0y8w1x/daemon_carrier_board/README.md

# daemon_carrier_board
an improved revision is available here: https://github.com/0y8w1x/daemon_baseboard
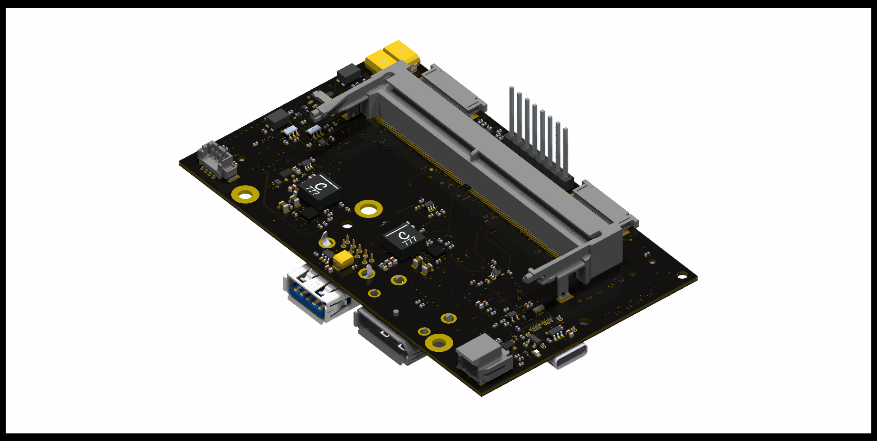
[picture p1: daemon_carrier_board_front.png]
board_render_front

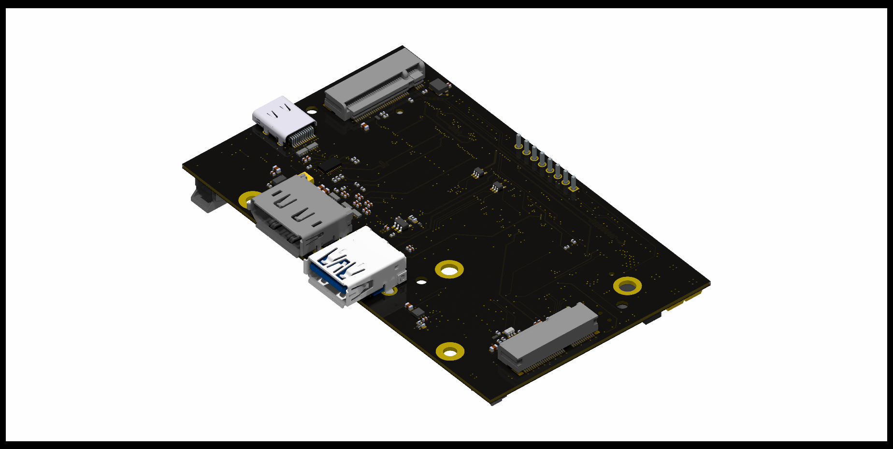
[picture p2: daemon_carrier_board_back.png]
board_render_back
