0y8w1x/daemon_carrier_board/csi.kicad_sch

## KiCad design csi.kicad_sch (2024-04-20)

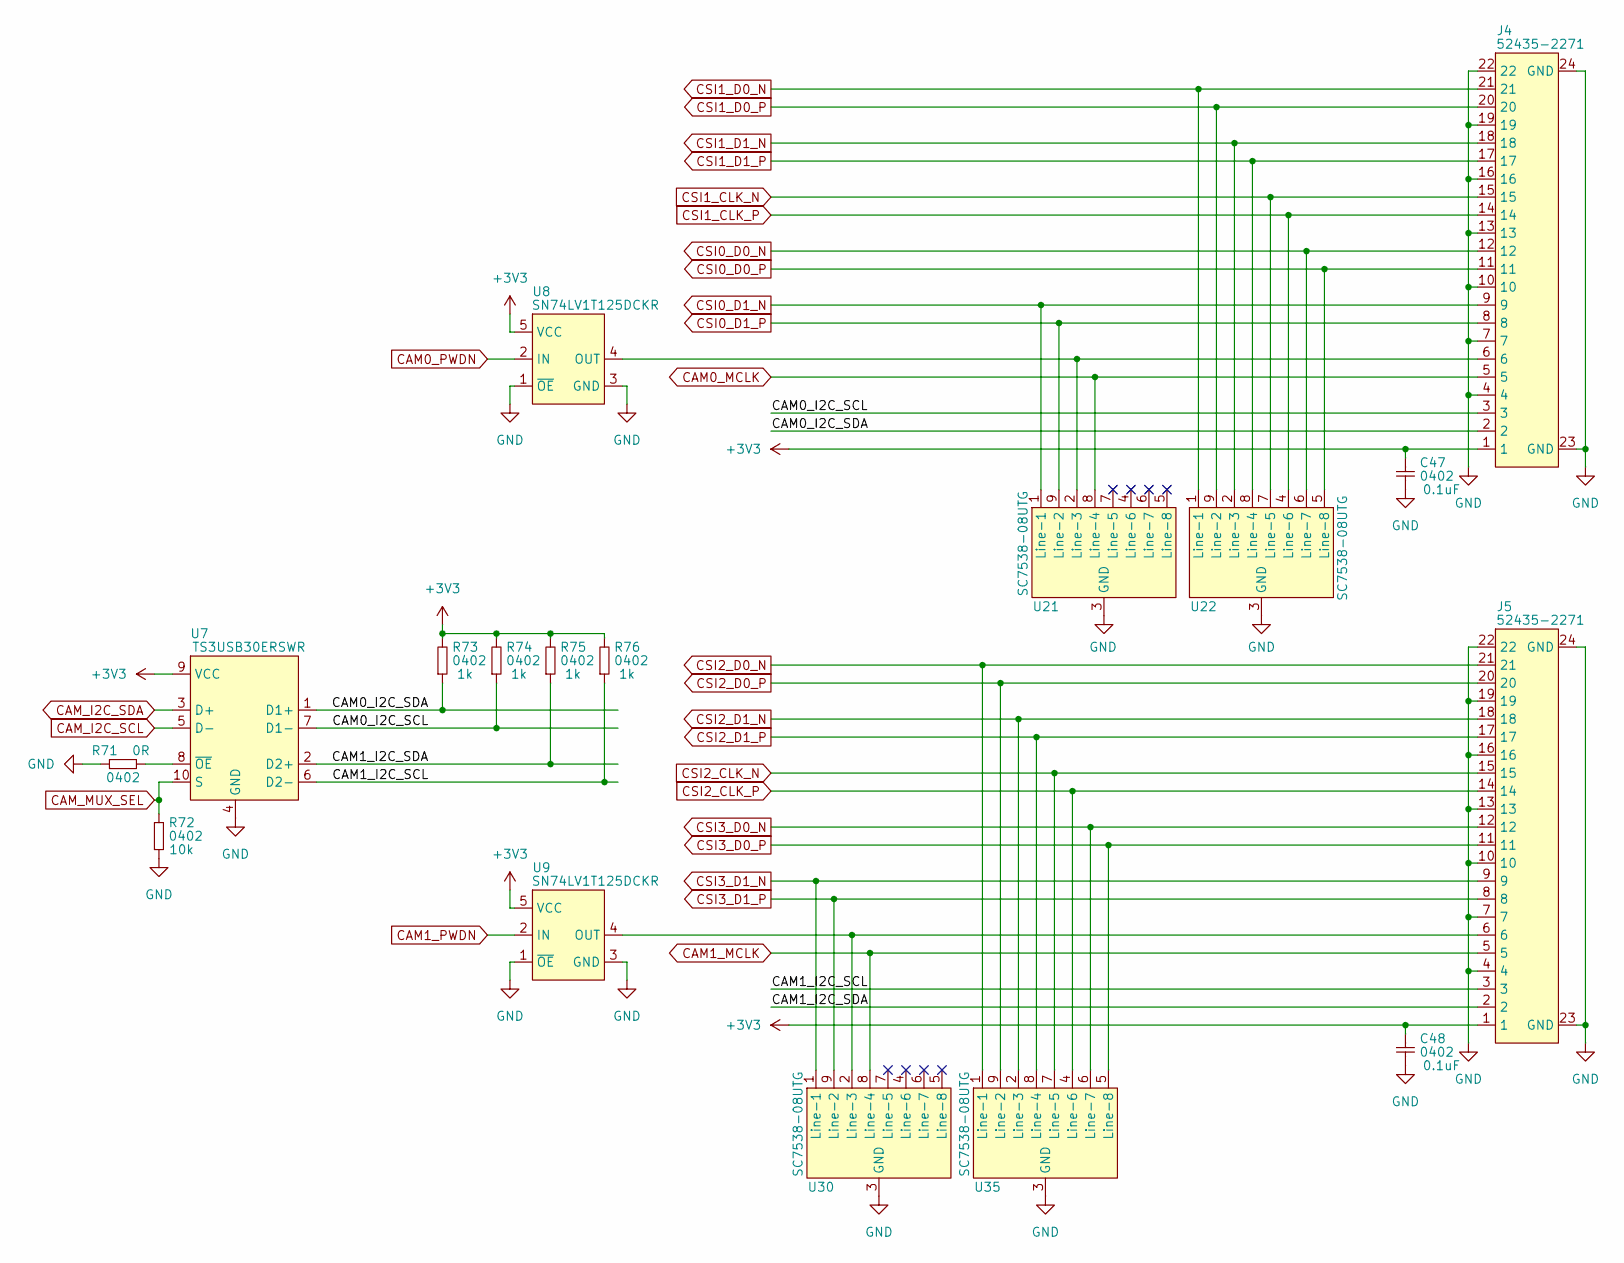
[picture p10: schematic csi.kicad_sch]

Parts:
C47, C48: 0.1uF; 0402_cap
J4, J5: 52435-2271
R71: 0R; 0402_res
R72: 10k; 0402_res
R73, R74, R75, R76: 1k; 0402_res
U7: TS3USB30E
U8, U9: SN74LV1T125
U21, U22, U30, U35: SC7538

Connections:
+3V3: C47.2, C48.2, J4.1, J5.1, R73.2, R74.2, R75.2, R76.2, U7.9 (VCC), U8.5 (VCC), U9.5 (VCC)
CAM0_I2C_SCL: J4.3, R74.1, U7.7 (D1-)
CAM0_I2C_SDA: J4.2, R73.1, U7.1 (D1+)
CAM0_MCLK: J4.5, U21.8 (Line-4)
CAM0_PWDN: U8.2 (IN)
CAM1_I2C_SCL: J5.3, R76.1, U7.6 (D2-)
CAM1_I2C_SDA: J5.2, R75.1, U7.2 (D2+)
CAM1_MCLK: J5.5, U30.8 (Line-4)
CAM1_PWDN: U9.2 (IN)
CAM_I2C_SCL: U7.5 (D-)
CAM_I2C_SDA: U7.3 (D+)
CAM_MUX_SEL: R72.2, U7.10 (S)
CSI0_D0_N: J4.12, U22.6 (Line-7)
CSI0_D0_P: J4.11, U22.5 (Line-8)
CSI0_D1_N: J4.9, U21.1 (Line-1)
CSI0_D1_P: J4.8, U21.9 (Line-2)
CSI1_CLK_N: J4.15, U22.7 (Line-5)
CSI1_CLK_P: J4.14, U22.4 (Line-6)
CSI1_D0_N: J4.21, U22.1 (Line-1)
CSI1_D0_P: J4.20, U22.9 (Line-2)
CSI1_D1_N: J4.18, U22.2 (Line-3)
CSI1_D1_P: J4.17, U22.8 (Line-4)
CSI2_CLK_N: J5.15, U35.7 (Line-5)
CSI2_CLK_P: J5.14, U35.4 (Line-6)
CSI2_D0_N: J5.21, U35.1 (Line-1)
CSI2_D0_P: J5.20, U35.9 (Line-2)
CSI2_D1_N: J5.18, U35.2 (Line-3)
CSI2_D1_P: J5.17, U35.8 (Line-4)
CSI3_D0_N: J5.12, U35.6 (Line-7)
CSI3_D0_P: J5.11, U35.5 (Line-8)
CSI3_D1_N: J5.9, U30.1 (Line-1)
CSI3_D1_P: J5.8, U30.9 (Line-2)
GND: C47.1, C48.1, J4.4, J4.7, J4.10, J4.13, J4.16, J4.19, J4.22, J4.23 (GND), J4.24 (GND), J5.4, J5.7, J5.10, J5.13, J5.16, J5.19, J5.22, J5.23 (GND), J5.24 (GND), R71.1, R72.1, U7.4 (GND), U8.1 (~OE), U8.3 (GND), U9.1 (~OE), U9.3 (GND), U21.3 (GND), U22.3 (GND), U30.3 (GND), U35.3 (GND)
unnamed: J4.6, U8.4 (OUT), U21.2 (Line-3)
unnamed: J5.6, U9.4 (OUT), U30.2 (Line-3)
unnamed: R71.2, U7.8 (~OE)
