0y8w1x/daemon_carrier_board/display_port.kicad_sch

## KiCad design display_port.kicad_sch (2024-04-20)

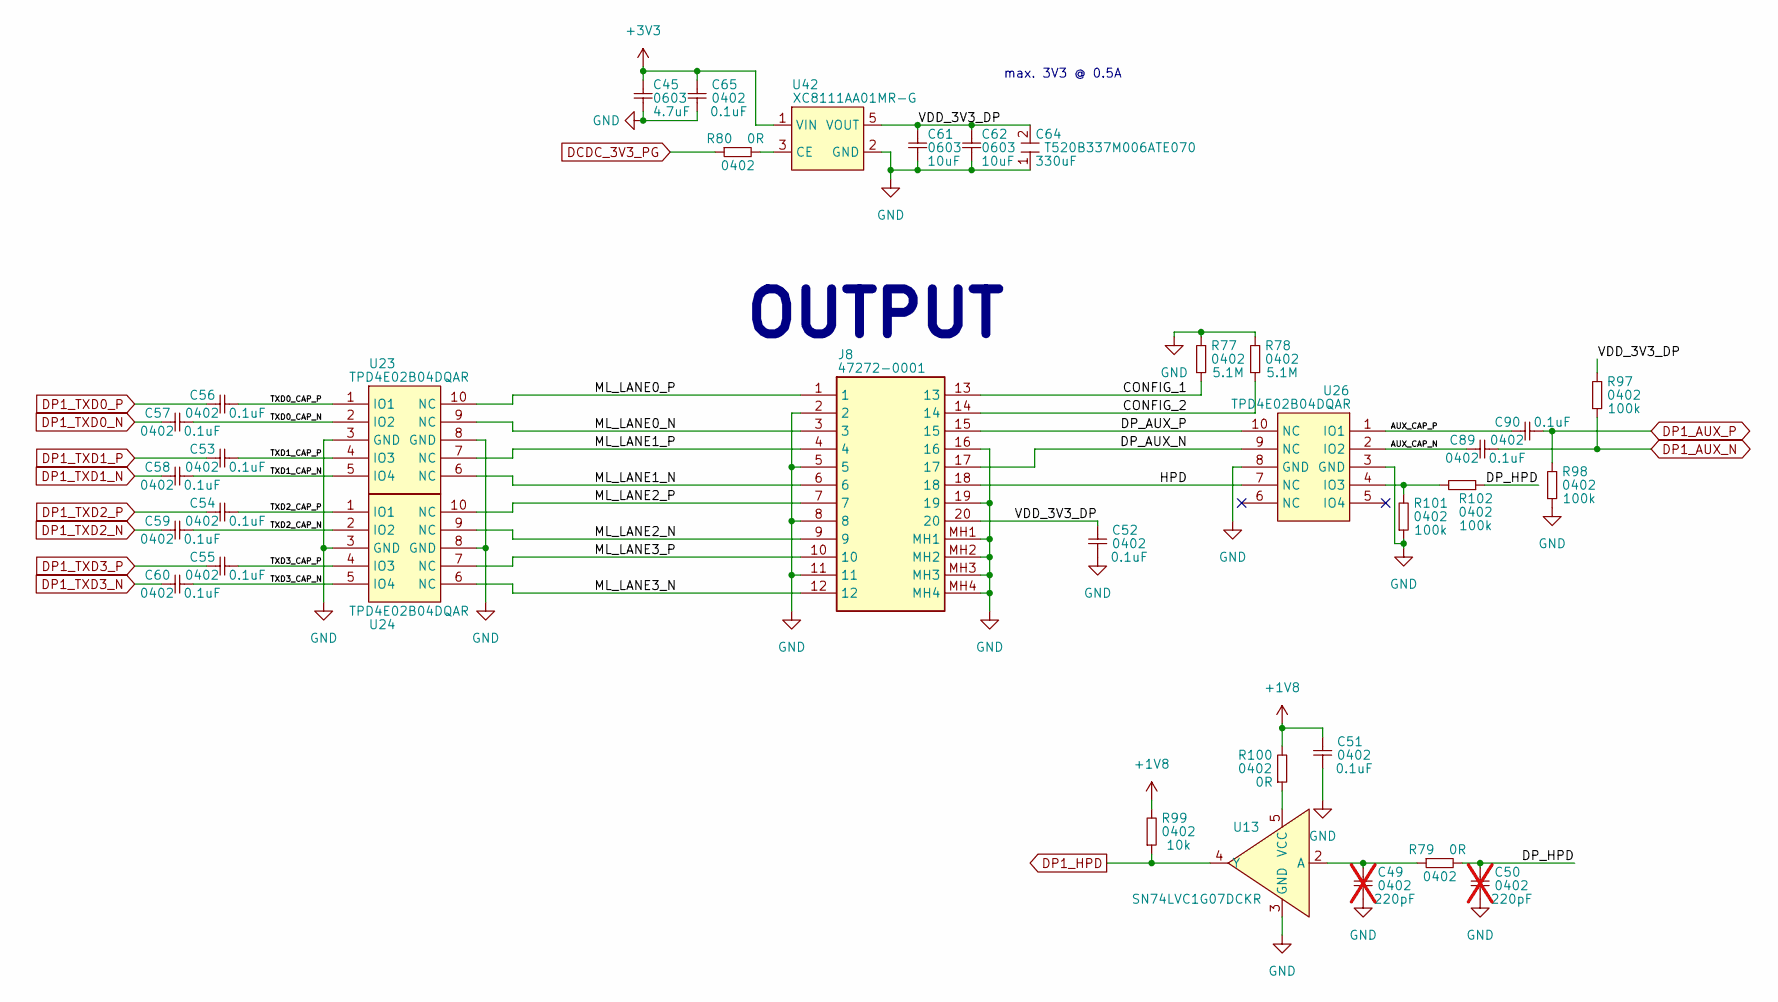
[picture p11: schematic display_port.kicad_sch]

Parts:
C45: 4.7uF; 0603_cap
C49, C50: 220pF; 0402_cap; not fitted
C51, C52, C53, C54, C55, C56, C57, C58, C59, C60, C65, C89, C90: 0.1uF; 0402_cap
C61, C62: 10uF; 0603_cap
C64: 330uF; T520B337M006ATE070
J8: 472720001; Mouser Part Number 538-47272-0001
R77, R78: 5.1M; 0402_res
R79, R80, R100: 0R; 0402_res
R97, R98, R101, R102: 100k; 0402_res
R99: 10k; 0402_res
U13: SN74LVC1G07
U23, U24, U26: TPD4E02B04DQAR
U42: XC8111

Connections:
+1V8: C51.2, R99.2, R100.2
+3V3: C45.2, C65.2, U42.1 (VIN)
AUX_CAP_N: C89.2, U26.2 (IO2)
AUX_CAP_P: C90.2, U26.1 (IO1)
CONFIG_1: J8.13, R77.1
CONFIG_2: J8.14, R78.1
DCDC_3V3_PG: R80.1
DP1_AUX_N: C89.1, R97.1
DP1_AUX_P: C90.1, R98.2
DP1_HPD: R99.1, U13.4 (Y)
DP1_TXD0_N: C57.2
DP1_TXD0_P: C56.2
DP1_TXD1_N: C58.2
DP1_TXD1_P: C53.2
DP1_TXD2_N: C59.2
DP1_TXD2_P: C54.2
DP1_TXD3_N: C60.2
DP1_TXD3_P: C55.2
DP_AUX_N: J8.17, U26.9 (NC)
DP_AUX_P: J8.15, U26.10 (NC)
DP_HPD: C50.2, R79.2, R102.1
GND: C45.1, C49.1, C50.1, C51.1, C52.1, C61.1, C62.1, C64.1, C65.1, J8.2, J8.5, J8.8, J8.11, J8.16, J8.19, J8.MH1, J8.MH2, J8.MH3, J8.MH4, R77.2, R78.2, R98.1, R101.1, U13.3 (GND), U23.3 (GND), U23.8 (GND), U24.3 (GND), U24.8 (GND), U26.3 (GND), U26.8 (GND), U42.2 (GND)
HPD: J8.18, U26.7 (NC)
ML_LANE0_N: J8.3, U23.9 (NC)
ML_LANE0_P: J8.1, U23.10 (NC)
ML_LANE1_N: J8.6, U23.6 (NC)
ML_LANE1_P: J8.4, U23.7 (NC)
ML_LANE2_N: J8.9, U24.9 (NC)
ML_LANE2_P: J8.7, U24.10 (NC)
ML_LANE3_N: J8.12, U24.6 (NC)
ML_LANE3_P: J8.10, U24.7 (NC)
unnamed: C49.2, R79.1, U13.2 (A)
unnamed: R80.2, U42.3 (CE)
unnamed: R100.1, U13.5 (VCC)
unnamed: R101.2, R102.2, U26.4 (IO3)
TXD0_CAP_N: C57.1, U23.2 (IO2)
TXD0_CAP_P: C56.1, U23.1 (IO1)
TXD1_CAP_N: C58.1, U23.5 (IO4)
TXD1_CAP_P: C53.1, U23.4 (IO3)
TXD2_CAP_N: C59.1, U24.2 (IO2)
TXD2_CAP_P: C54.1, U24.1 (IO1)
TXD3_CAP_N: C60.1, U24.5 (IO4)
TXD3_CAP_P: C55.1, U24.4 (IO3)
VDD_3V3_DP: C52.2, C61.2, C62.2, C64.2, J8.20, R97.2, U42.5 (VOUT)

Notes on the sheet:
max. 3V3 @ 0.5A
OUTPUT
