0y8w1x/daemon_carrier_board/gpio_fan_debug.kicad_sch

## KiCad design gpio_fan_debug.kicad_sch (2024-04-20)

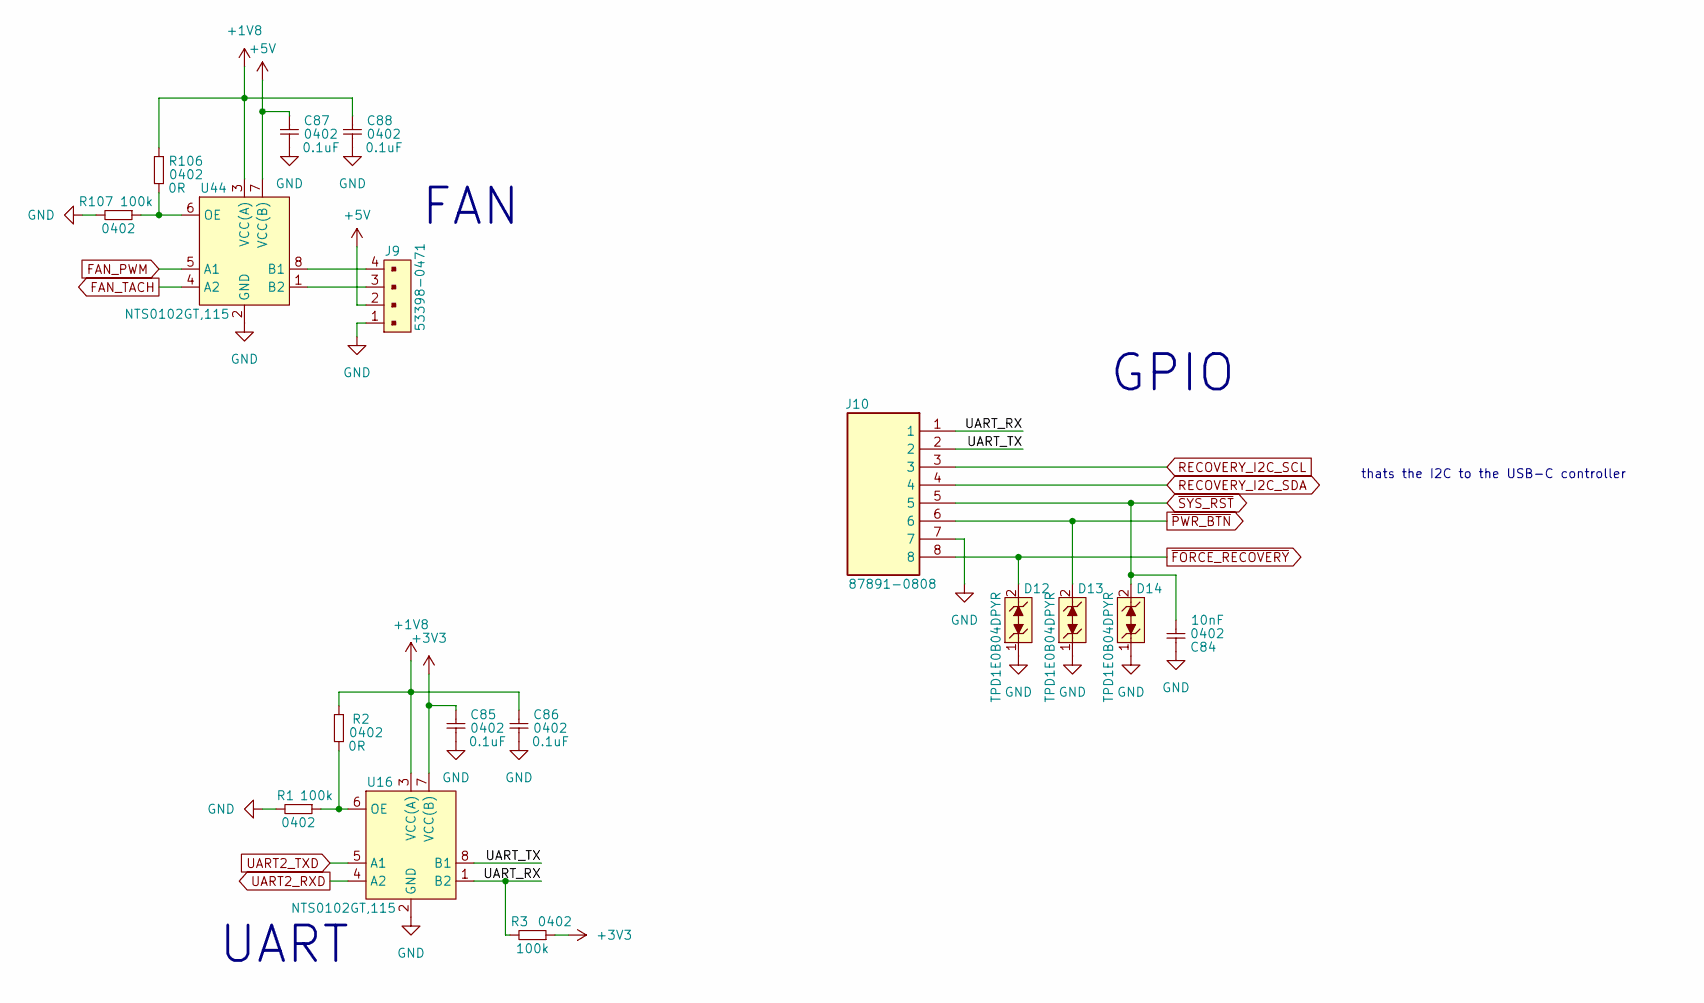
[picture p12: schematic gpio_fan_debug.kicad_sch]

Parts:
C84: 10nF; 0402_cap
C85, C86, C87, C88: 0.1uF; 0402_cap
D12, D13, D14: XDFN-2_1x0.60mm; MPN TPD1E0B04DPYR
J9: Molex_PicoBlade_53398-0471_1x04-1MP_P1.25mm_Vertical; MPN 0533980471
J10: HDRV8W69P0X254_1X8_2032X251X1641P; Mouser Part Number 538-87891-0808
R1, R3, R107: 100k; 0402_res
R2, R106: 0R; 0402_res
U16, U44: NTS0102

Connections:
+1V8: C86.2, C88.2, R2.2, R106.2, U16.3 (VCC(A)), U44.3 (VCC(A))
+3V3: C85.2, R3.1, U16.7 (VCC(B))
+5V: C87.2, J9.2, U44.7 (VCC(B))
FAN_PWM: U44.5 (A1)
FAN_TACH: U44.4 (A2)
GND: C84.2, C85.1, C86.1, C87.1, C88.1, D12.1, D13.1, D14.1, J9.1, J10.7, R1.2, R107.2, U16.2 (GND), U44.2 (GND)
unnamed: J9.3, U44.1 (B2)
unnamed: J9.4, U44.8 (B1)
unnamed: R1.1, R2.1, U16.6 (OE)
unnamed: R106.1, R107.1, U44.6 (OE)
RECOVERY_I2C_SCL: J10.3
RECOVERY_I2C_SDA: J10.4
UART2_RXD: U16.4 (A2)
UART2_TXD: U16.5 (A1)
UART_RX: J10.1, R3.2, U16.1 (B2)
UART_TX: J10.2, U16.8 (B1)
~FORCE_RECOVERY: D12.2, J10.8
~PWR_BTN: D13.2, J10.6
~SYS_RST: C84.1, D14.2, J10.5

Notes on the sheet:
UART
thats the I2C to the USB-C controller
FAN
GPIO
