0y8w1x/daemon_carrier_board/ldo_3V3_5V.kicad_sch

## KiCad design ldo_3V3_5V.kicad_sch (2024-04-20)

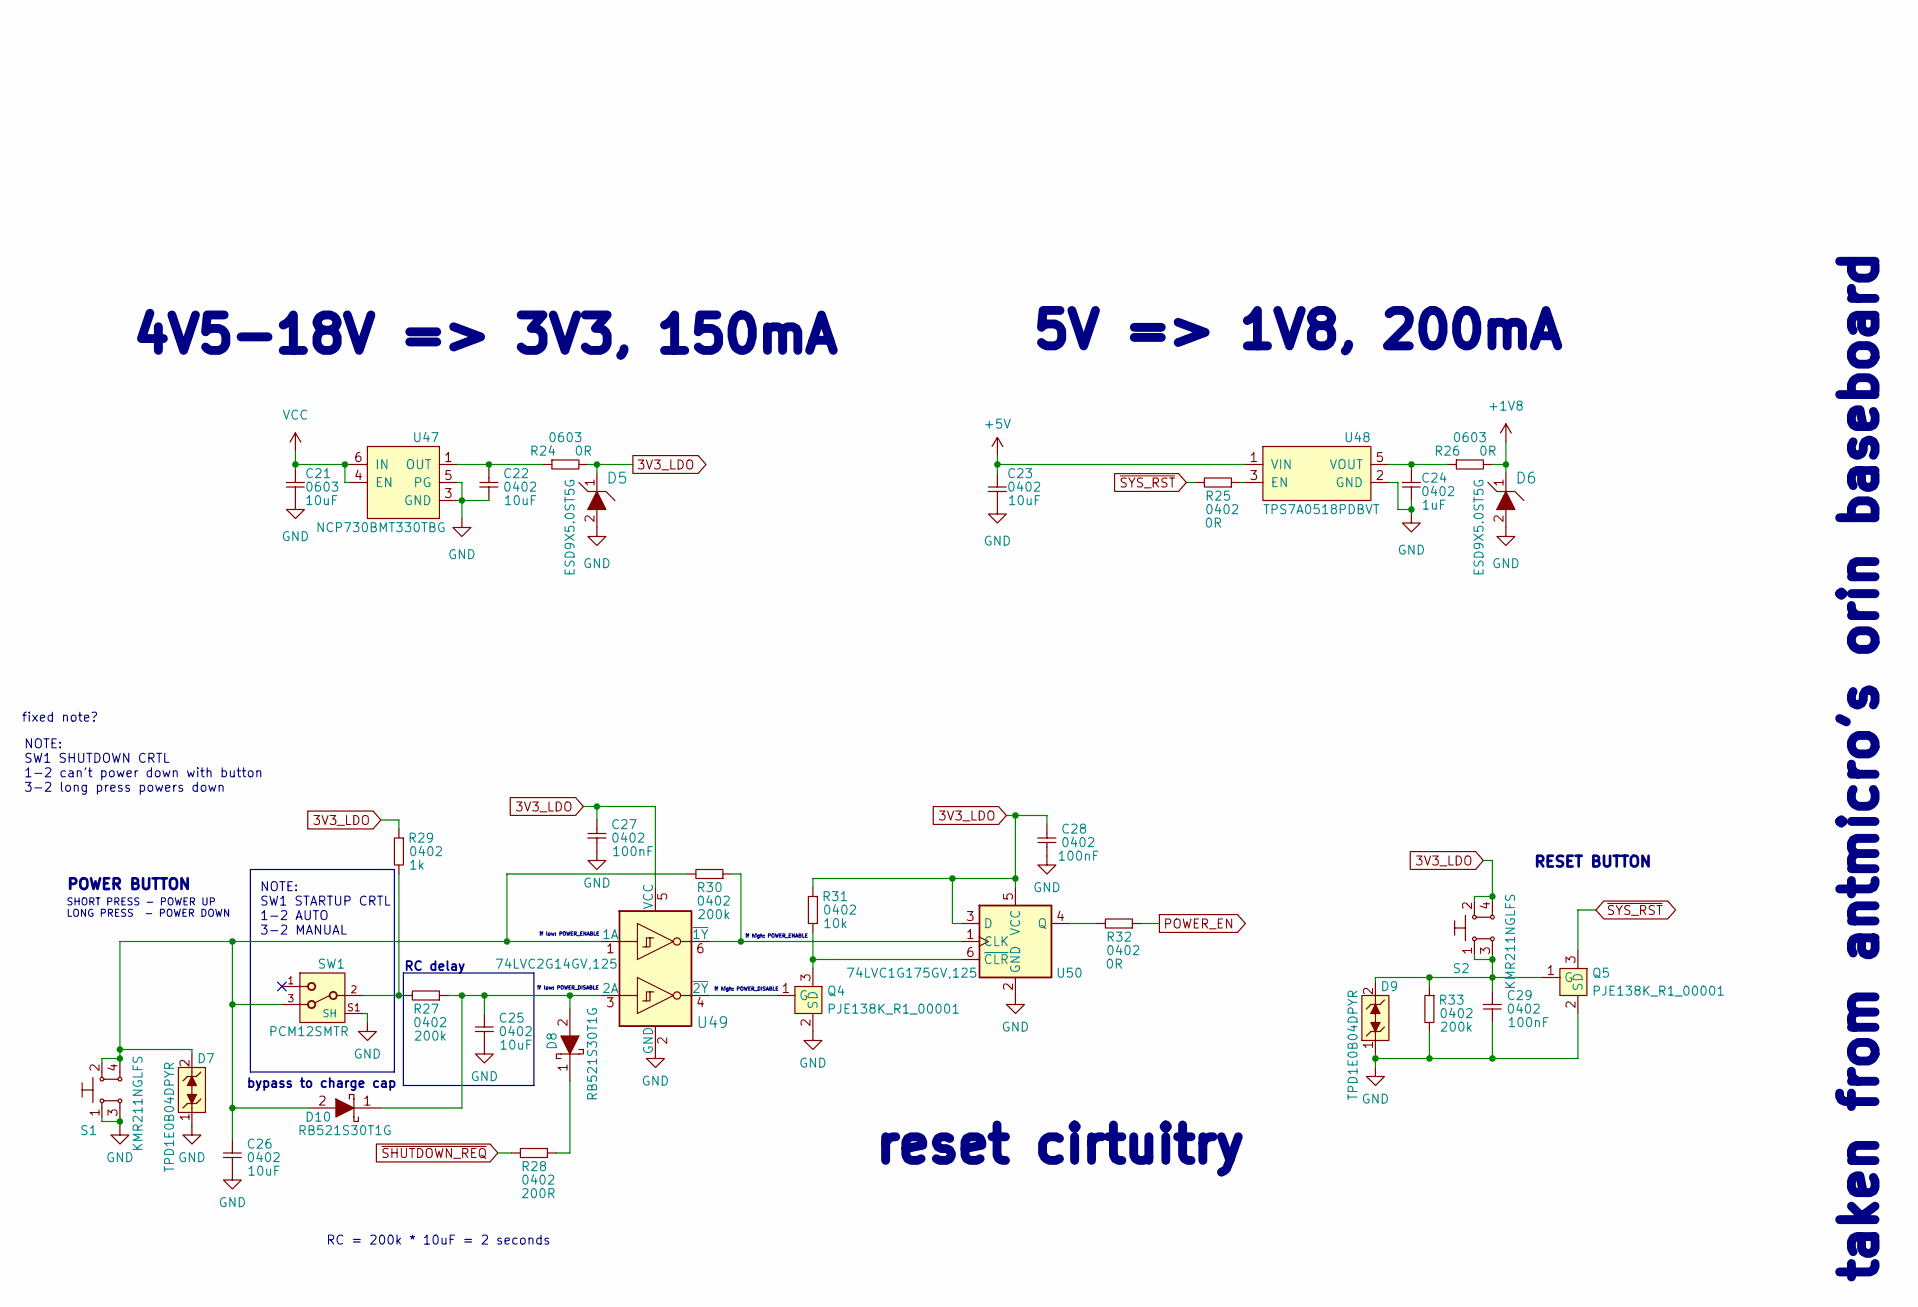
[picture p13: schematic ldo_3V3_5V.kicad_sch]

Parts:
C21: 10uF; 0603_cap
C22, C23, C25, C26: 10uF; 0402_cap
C24: 1uF; 0402_cap
C27, C28, C29: 100nF; 0402_cap
D5, D6: SOD-923; MPN ESD9X5.0ST5G
D7, D9: XDFN-2_1x0.60mm; MPN TPD1E0B04DPYR
D8, D10: SOD-523; MPN RB521S30T1G
Q4, Q5: PJE138K
R24, R26: 0R; 0603_res
R25, R32: 0R; 0402_res
R27, R30, R33: 200k; 0402_res
R28: 200R; 0402_res
R29: 1k; 0402_res
R31: 10k; 0402_res
S1, S2: SW_SPST_4.2x2.8; MPN KMR211NGLFS
SW1: PCM12SMTR; MPN PCM13SMTR
U47: WSON6_TI_2x2mm; MPN NCP730BMT330TBG
U48: SOT-23-5; MPN TPS7A0518PDBVT
U49: SOT23-6L; MPN 74LVC2G14GV,125
U50: SOT-23-6; MPN 74LVC1G175GV,125

Connections:
3V3_LDO: C27.2, C28.2, D5.1, R24.2, R29.1, R31.1, S2.2, S2.4, U49.5 (VCC), U50.3 (D), U50.5 (VCC)
+1V8: D6.1, R26.2
+5V: C23.2, U48.1 (VIN)
GND: C21.1, C22.1, C23.1, C24.1, C25.1, C26.1, C27.1, C28.1, C29.1, D5.2, D6.2, D7.1, D9.1, Q4.2 (S), Q5.2 (S), R33.2, S1.1, S1.3, SW1.S1 (SH), SW1.S2 (SH), SW1.S3 (SH), SW1.S4 (SH), U47.3 (GND), U47.5 (PG), U47.7 (EP), U48.2 (GND), U49.2 (GND), U50.2 (GND)
unnamed: C22.2, R24.1, U47.1 (OUT)
unnamed: C24.2, R26.1, U48.5 (VOUT)
unnamed: C25.2, D8.2, D10.1, R27.1, U49.3 (2A)
unnamed: C26.2, D7.2, D10.2, R30.2, S1.2, S1.4, SW1.3, U49.1 (1A)
unnamed: C29.2, D9.2, Q5.1 (G), R33.1, S2.1, S2.3
unnamed: D8.1, R28.1
unnamed: Q4.1 (G), U49.4 (~2Y)
unnamed: Q4.3 (D), R31.2, U50.6 (~CLR)
unnamed: R25.1, U48.3 (EN)
unnamed: R27.2, R29.2, SW1.2
unnamed: R30.1, U49.6 (~1Y), U50.1 (CLK)
unnamed: R32.2, U50.4 (Q)
POWER_EN: R32.1
VCC: C21.2, U47.4 (EN), U47.6 (IN)
~SHUTDOWN_REQ: R28.2
~SYS_RST: Q5.3 (D), R25.2

Notes on the sheet:
5V => 1V8, 200mA
bypass to charge cap
if low: POWER_DISABLE
RC = 200k * 10uF = 2 seconds
NOTE: SW1 SHUTDOWN CRTL 1-2 can't power down with button 3-2 long press powers down
if high: POWER_ENABLE
SHORT PRESS - POWER UP LONG PRESS - POWER DOWN
POWER BUTTON
RESET BUTTON
if high: POWER_DISABLE
reset cirtuitry
fixed note?
4V5-18V => 3V3, 150mA
if low: POWER_ENABLE
taken from antmicro's orin baseboard
NOTE: SW1 STARTUP CRTL 1-2 AUTO 3-2 MANUAL
RC delay
