0y8w1x/daemon_carrier_board/m.2e_wifi_bt.kicad_sch

## KiCad design m.2e_wifi_bt.kicad_sch (2024-04-20)

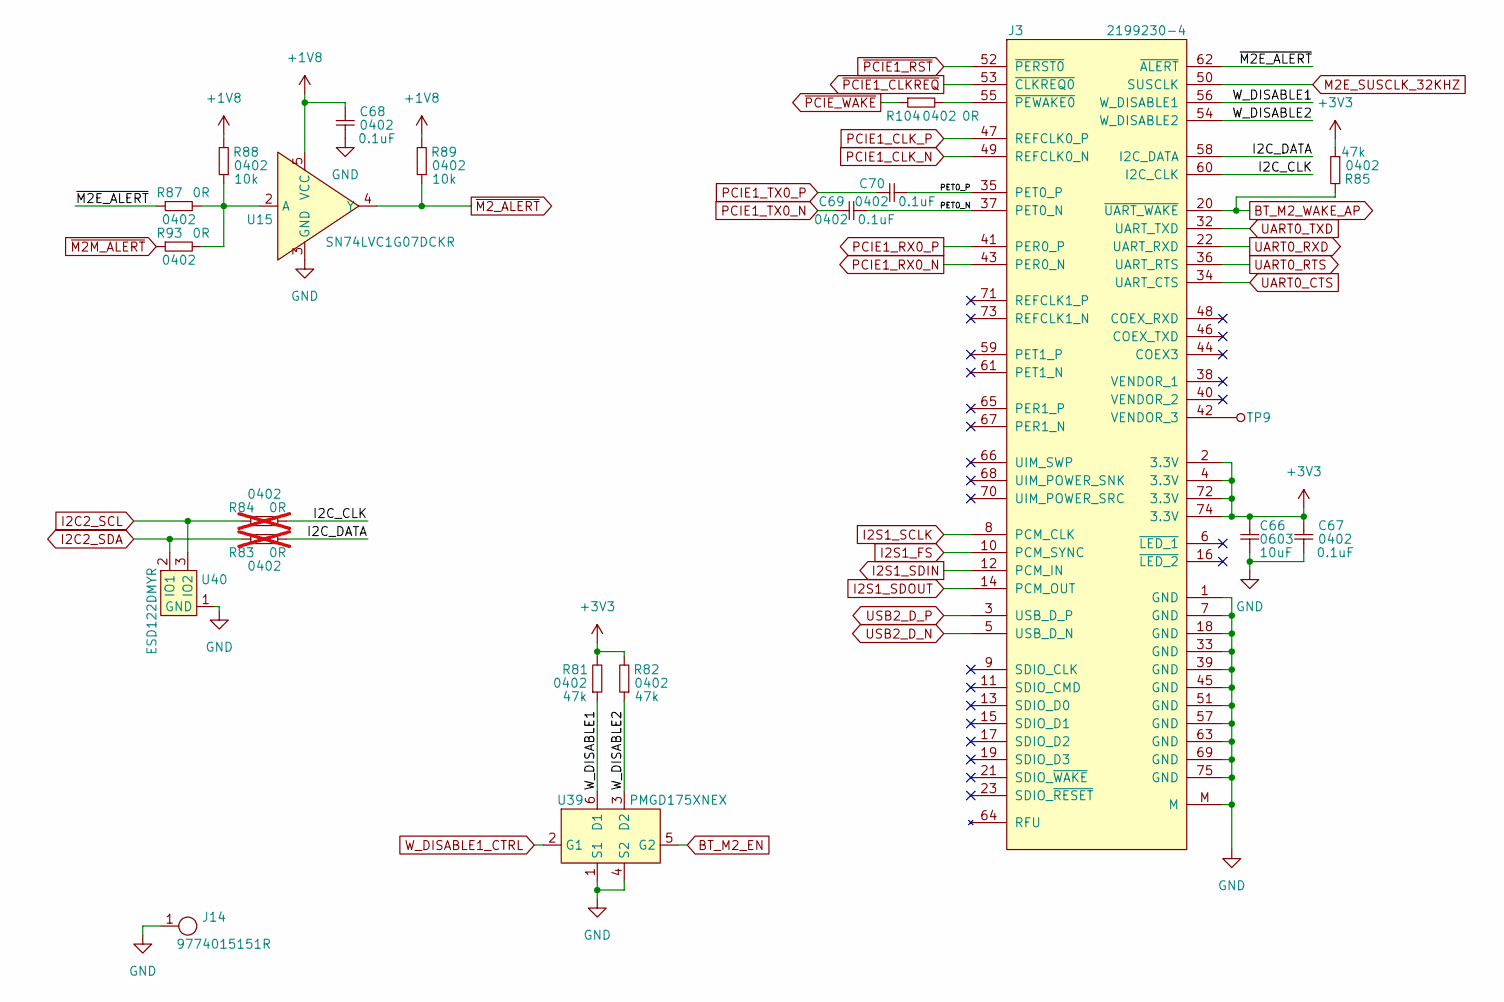
[picture p14: schematic m.2e_wifi_bt.kicad_sch]

Parts:
C66: 10uF; 0603_cap
C67, C68, C69, C70: 0.1uF; 0402_cap
J3: 2199230-4; MPN 2199230-6
J14: m.2_mounting
R81, R82, R85: 47k; 0402_res
R83, R84: 0R; 0402_res; not fitted
R87, R93, R104: 0R; 0402_res
R88, R89: 10k; 0402_res
TP9: TP_SMD_0_75MM; Testpoint_smd_0_75mm
U15: SN74LVC1G07
U39: PMGD175XNE
U40: ESD122DMY

Connections:
+1V8: C68.2, R88.2, R89.2, U15.5 (VCC)
+3V3: C66.2, C67.2, J3.2 (3.3V), J3.4 (3.3V), J3.72 (3.3V), J3.74 (3.3V), R81.2, R82.2, R85.1
BT_M2_EN: U39.5 (G2)
BT_M2_WAKE_AP: J3.20 (~UART_WAKE), R85.2
GND: C66.1, C67.1, C68.1, J3.1 (GND), J3.7 (GND), J3.18 (GND), J3.33 (GND), J3.39 (GND), J3.45 (GND), J3.51 (GND), J3.57 (GND), J3.63 (GND), J3.69 (GND), J3.75 (GND), J3.M, J14.1, U15.3 (GND), U39.1 (S1), U39.4 (S2), U40.1 (GND)
I2C2_SCL: R84.1, U40.3 (IO2)
I2C2_SDA: R83.1, U40.2 (IO1)
I2C_CLK: J3.60 (I2C_CLK), R84.2
I2C_DATA: J3.58 (I2C_DATA), R83.2
I2S1_FS: J3.10 (PCM_SYNC)
I2S1_SCLK: J3.8 (PCM_CLK)
I2S1_SDIN: J3.12 (PCM_IN)
I2S1_SDOUT: J3.14 (PCM_OUT)
M2E_SUSCLK_32KHZ: J3.50 (SUSCLK)
unnamed: J3.42 (VENDOR_3), TP9.1
unnamed: J3.55 (~PEWAKE0), R104.2
unnamed: R87.2, R88.1, R93.2, U15.2 (A)
PCIE1_CLK_N: J3.49 (REFCLK0_N)
PCIE1_CLK_P: J3.47 (REFCLK0_P)
PCIE1_RX0_N: J3.43 (PER0_N)
PCIE1_RX0_P: J3.41 (PER0_P)
PCIE1_TX0_N: C69.2
PCIE1_TX0_P: C70.2
PET0_N: C69.1, J3.37 (PET0_N)
PET0_P: C70.1, J3.35 (PET0_P)
UART0_CTS: J3.34 (UART_CTS)
UART0_RTS: J3.36 (UART_RTS)
UART0_RXD: J3.22 (UART_RXD)
UART0_TXD: J3.32 (UART_TXD)
USB2_D_N: J3.5 (USB_D_N)
USB2_D_P: J3.3 (USB_D_P)
W_DISABLE1: J3.56 (W_DISABLE1), R81.1, U39.6 (D1)
W_DISABLE1_CTRL: U39.2 (G1)
W_DISABLE2: J3.54 (W_DISABLE2), R82.1, U39.3 (D2)
~M2E_ALERT: J3.62 (~ALERT), R87.1
~M2M_ALERT: R93.1
~M2_ALERT: R89.1, U15.4 (Y)
~PCIE1_CLKREQ: J3.53 (~CLKREQ0)
~PCIE1_RST: J3.52 (~PERST0)
~PCIE_WAKE: R104.1
