0y8w1x/daemon_carrier_board/m.2m_nvme.kicad_sch

## KiCad design m.2m_nvme.kicad_sch (2024-04-20)

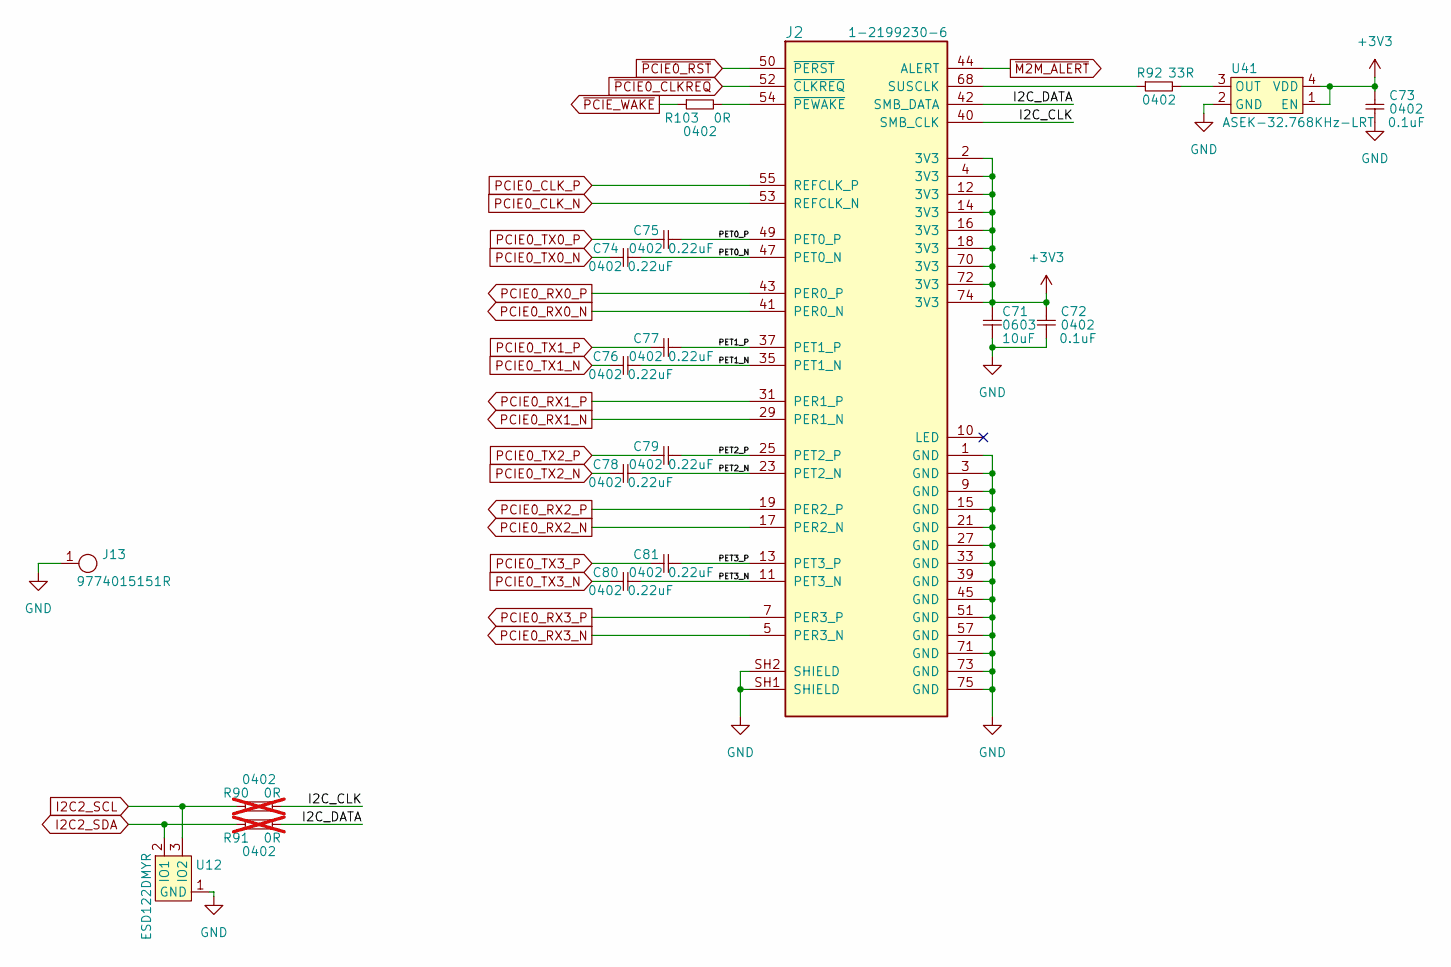
[picture p15: schematic m.2m_nvme.kicad_sch]

Parts:
C71: 10uF; 0603_cap
C72, C73: 0.1uF; 0402_cap
C74, C75, C76, C77, C78, C79, C80, C81: 0.22uF; 0402_cap
J2: 1-2199230-6; MPN 1-2199230-6
J13: m.2_mounting
R90, R91: 0R; 0402_res; not fitted
R92: 33R; 0402_res
R103: 0R; 0402_res
U12: ESD122DMY
U41: ASEK-32.768KHz-LRT

Connections:
+3V3: C71.2, C72.2, C73.2, J2.2 (3V3), J2.4 (3V3), J2.12 (3V3), J2.14 (3V3), J2.16 (3V3), J2.18 (3V3), J2.70 (3V3), J2.72 (3V3), J2.74 (3V3), U41.1 (EN), U41.4 (VDD)
GND: C71.1, C72.1, C73.1, J2.1 (GND), J2.3 (GND), J2.9 (GND), J2.15 (GND), J2.21 (GND), J2.27 (GND), J2.33 (GND), J2.39 (GND), J2.45 (GND), J2.51 (GND), J2.57 (GND), J2.71 (GND), J2.73 (GND), J2.75 (GND), J2.SH1 (SHIELD), J2.SH2 (SHIELD), J13.1, U12.1 (GND), U41.2 (GND)
I2C2_SCL: R90.1, U12.3 (IO2)
I2C2_SDA: R91.1, U12.2 (IO1)
I2C_CLK: J2.40 (SMB_CLK), R90.2
I2C_DATA: J2.42 (SMB_DATA), R91.2
unnamed: J2.54 (~PEWAKE), R103.2
unnamed: J2.68 (SUSCLK), R92.1
unnamed: R92.2, U41.3 (OUT)
PCIE0_CLK_N: J2.53 (REFCLK_N)
PCIE0_CLK_P: J2.55 (REFCLK_P)
PCIE0_RX0_N: J2.41 (PER0_N)
PCIE0_RX0_P: J2.43 (PER0_P)
PCIE0_RX1_N: J2.29 (PER1_N)
PCIE0_RX1_P: J2.31 (PER1_P)
PCIE0_RX2_N: J2.17 (PER2_N)
PCIE0_RX2_P: J2.19 (PER2_P)
PCIE0_RX3_N: J2.5 (PER3_N)
PCIE0_RX3_P: J2.7 (PER3_P)
PCIE0_TX0_N: C74.2
PCIE0_TX0_P: C75.2
PCIE0_TX1_N: C76.2
PCIE0_TX1_P: C77.2
PCIE0_TX2_N: C78.2
PCIE0_TX2_P: C79.2
PCIE0_TX3_N: C80.2
PCIE0_TX3_P: C81.2
PET0_N: C74.1, J2.47 (PET0_N)
PET0_P: C75.1, J2.49 (PET0_P)
PET1_N: C76.1, J2.35 (PET1_N)
PET1_P: C77.1, J2.37 (PET1_P)
PET2_N: C78.1, J2.23 (PET2_N)
PET2_P: C79.1, J2.25 (PET2_P)
PET3_N: C80.1, J2.11 (PET3_N)
PET3_P: C81.1, J2.13 (PET3_P)
~M2M_ALERT: J2.44 (ALERT)
~PCIE0_CLKREQ: J2.52 (~CLKREQ)
~PCIE0_RST: J2.50 (~PERST)
~PCIE_WAKE: R103.1
