0y8w1x/daemon_carrier_board/som.kicad_sch

## KiCad design som.kicad_sch (2024-04-20)

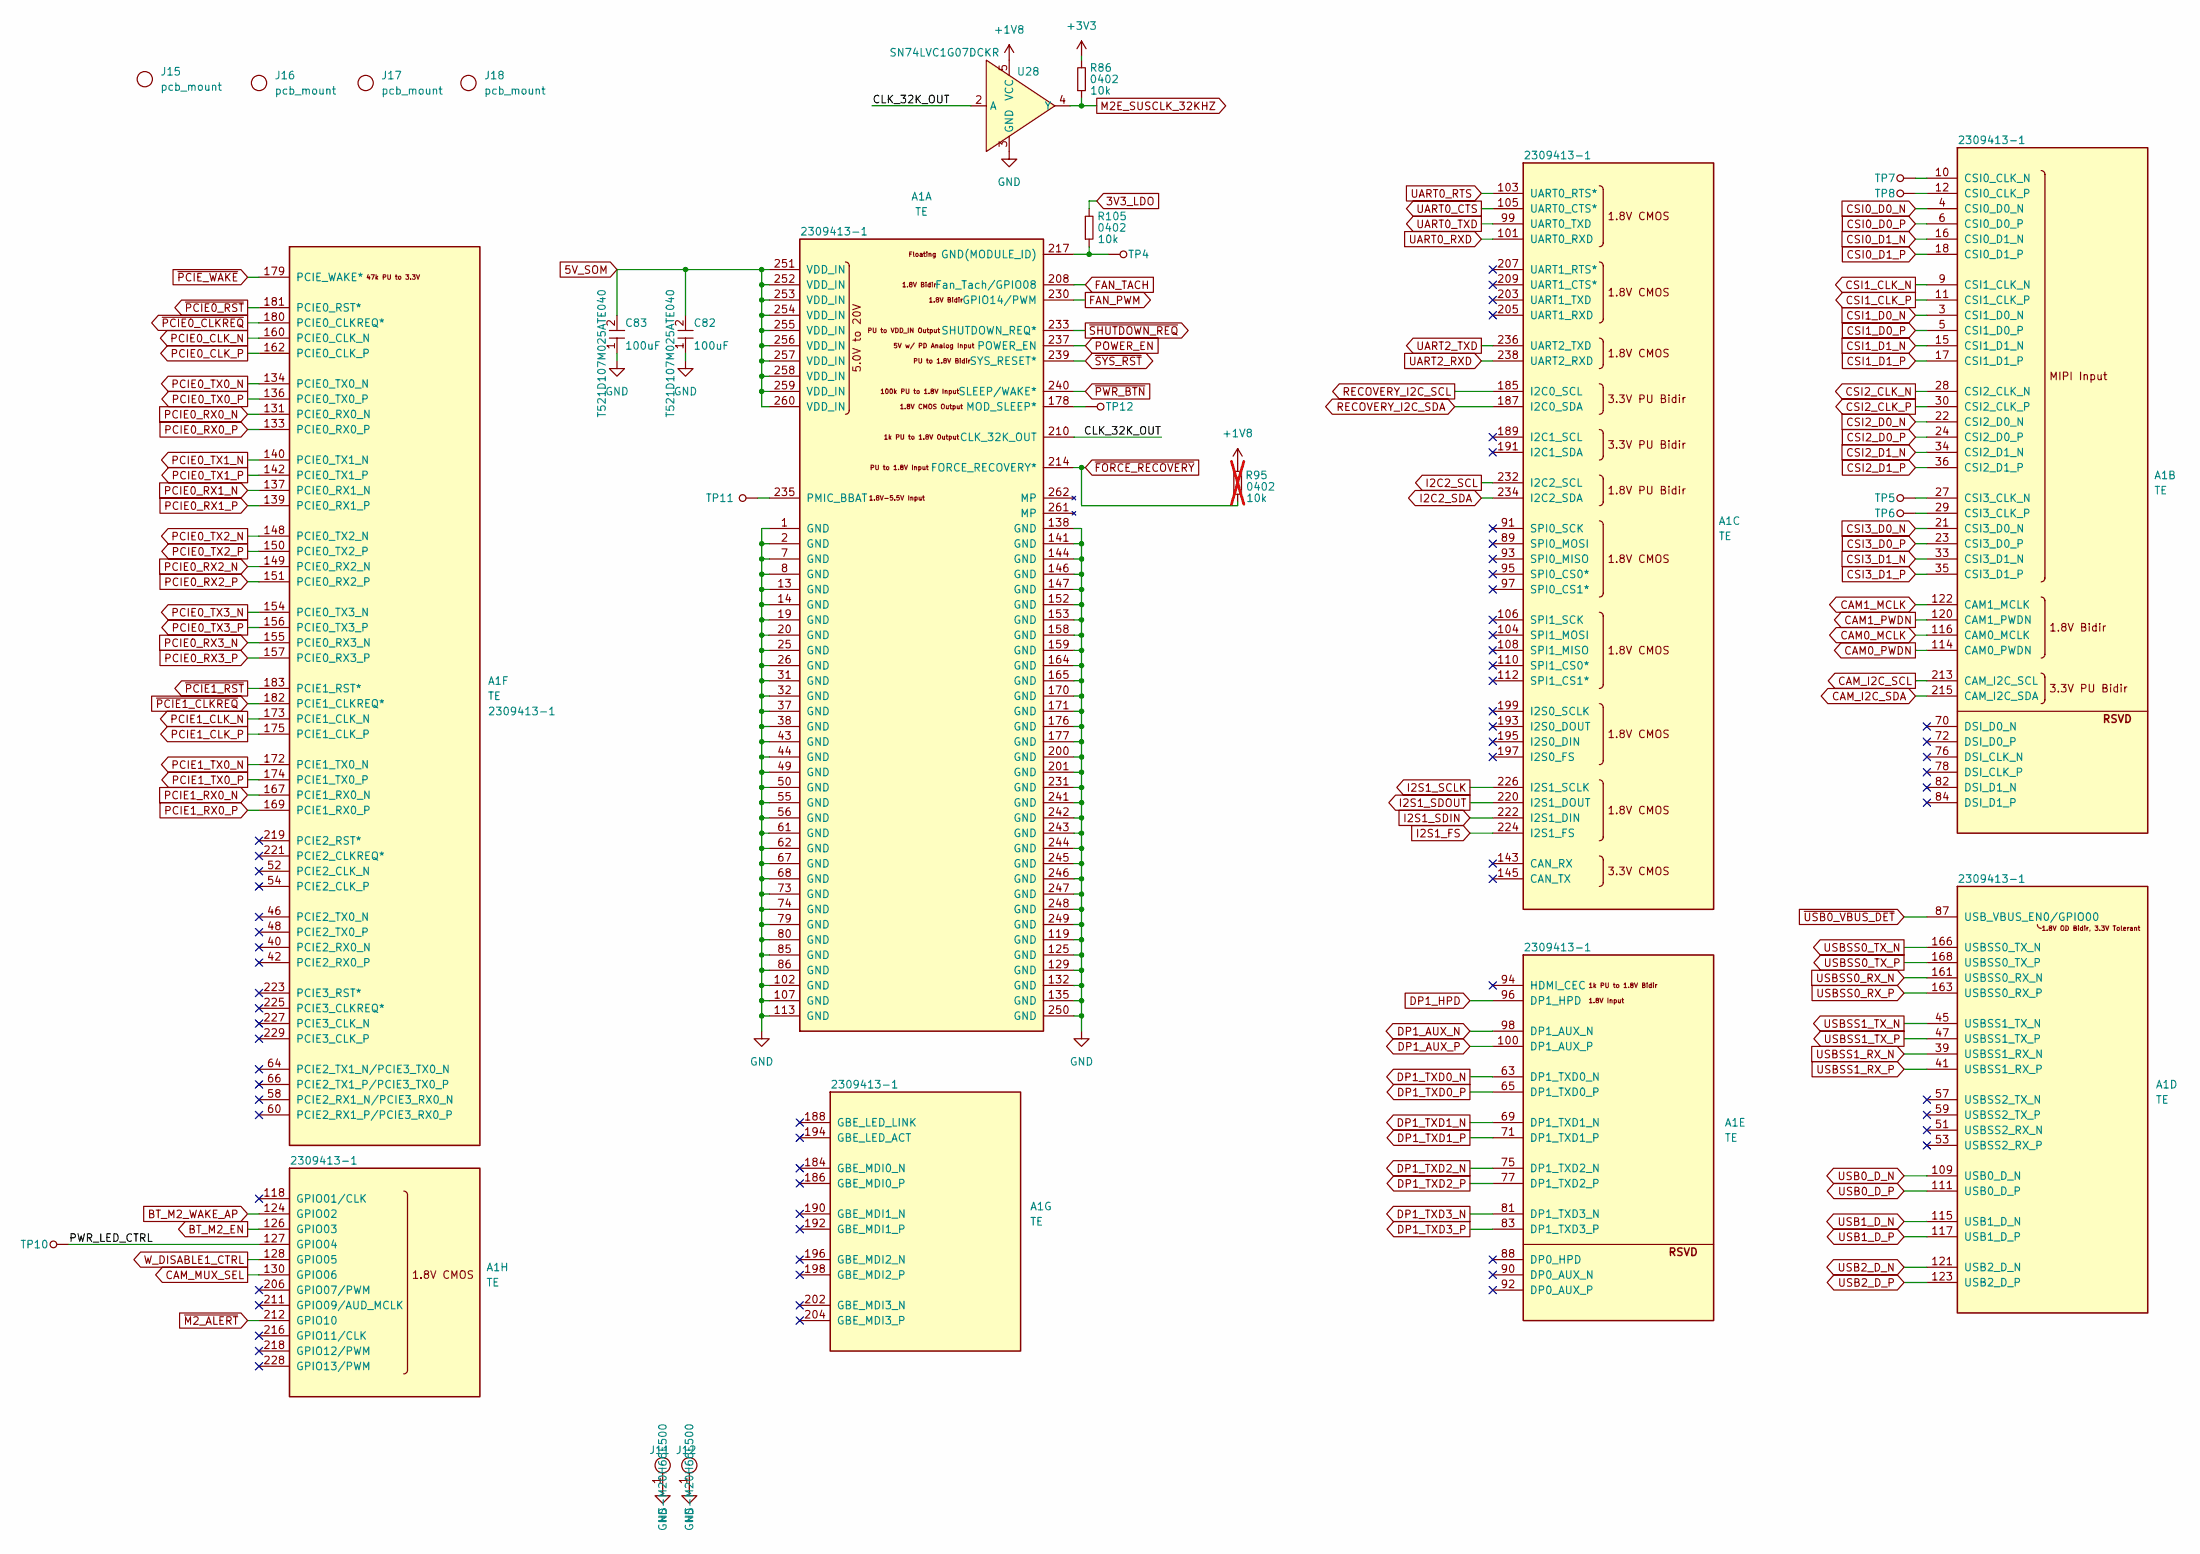
[picture p16: schematic som.kicad_sch]

Parts:
A1: Jetson-Orin-9.2H-socket; TE_2309413
C82, C83: 100uF; T521D107M025ATE040
J11, J12: jetson_mounting_hole
J15, J16, J17, J18: pcb_mount
R86, R105: 10k; 0402_res
R95: 10k; 0402_res; not fitted
TP4, TP5, TP6, TP7, TP8, TP10, TP11, TP12: TP_SMD_0_75MM; Testpoint_smd_0_75mm
U28: SN74LVC1G07

Connections:
3V3_LDO: R105.2
5V_SOM: A1.251 (VDD_IN), A1.252 (VDD_IN), A1.253 (VDD_IN), A1.254 (VDD_IN), A1.255 (VDD_IN), A1.256 (VDD_IN), A1.257 (VDD_IN), A1.258 (VDD_IN), A1.259 (VDD_IN), A1.260 (VDD_IN), C82.2, C83.2
+1V8: R95.2, U28.5 (VCC)
+3V3: R86.2
BT_M2_EN: A1.126 (GPIO03)
BT_M2_WAKE_AP: A1.124 (GPIO02)
CAM0_MCLK: A1.116 (CAM0_MCLK)
CAM0_PWDN: A1.114 (CAM0_PWDN)
CAM1_MCLK: A1.122 (CAM1_MCLK)
CAM1_PWDN: A1.120 (CAM1_PWDN)
CAM_I2C_SCL: A1.213 (CAM_I2C_SCL)
CAM_I2C_SDA: A1.215 (CAM_I2C_SDA)
CAM_MUX_SEL: A1.130 (GPIO06)
CLK_32K_OUT: A1.210 (CLK_32K_OUT), U28.2 (A)
CSI0_D0_N: A1.4 (CSI0_D0_N)
CSI0_D0_P: A1.6 (CSI0_D0_P)
CSI0_D1_N: A1.16 (CSI0_D1_N)
CSI0_D1_P: A1.18 (CSI0_D1_P)
CSI1_CLK_N: A1.9 (CSI1_CLK_N)
CSI1_CLK_P: A1.11 (CSI1_CLK_P)
CSI1_D0_N: A1.3 (CSI1_D0_N)
CSI1_D0_P: A1.5 (CSI1_D0_P)
CSI1_D1_N: A1.15 (CSI1_D1_N)
CSI1_D1_P: A1.17 (CSI1_D1_P)
CSI2_CLK_N: A1.28 (CSI2_CLK_N)
CSI2_CLK_P: A1.30 (CSI2_CLK_P)
CSI2_D0_N: A1.22 (CSI2_D0_N)
CSI2_D0_P: A1.24 (CSI2_D0_P)
CSI2_D1_N: A1.34 (CSI2_D1_N)
CSI2_D1_P: A1.36 (CSI2_D1_P)
CSI3_D0_N: A1.21 (CSI3_D0_N)
CSI3_D0_P: A1.23 (CSI3_D0_P)
CSI3_D1_N: A1.33 (CSI3_D1_N)
CSI3_D1_P: A1.35 (CSI3_D1_P)
DP1_AUX_N: A1.98 (DP1_AUX_N)
DP1_AUX_P: A1.100 (DP1_AUX_P)
DP1_HPD: A1.96 (DP1_HPD)
DP1_TXD0_N: A1.63 (DP1_TXD0_N)
DP1_TXD0_P: A1.65 (DP1_TXD0_P)
DP1_TXD1_N: A1.69 (DP1_TXD1_N)
DP1_TXD1_P: A1.71 (DP1_TXD1_P)
DP1_TXD2_N: A1.75 (DP1_TXD2_N)
DP1_TXD2_P: A1.77 (DP1_TXD2_P)
DP1_TXD3_N: A1.81 (DP1_TXD3_N)
DP1_TXD3_P: A1.83 (DP1_TXD3_P)
FAN_PWM: A1.230 (GPIO14/PWM)
FAN_TACH: A1.208 (Fan_Tach/GPIO08)
GND: A1.1 (GND), A1.2 (GND), A1.7 (GND), A1.8 (GND), A1.13 (GND), A1.14 (GND), A1.19 (GND), A1.20 (GND), A1.25 (GND), A1.26 (GND), A1.31 (GND), A1.32 (GND), A1.37 (GND), A1.38 (GND), A1.43 (GND), A1.44 (GND), A1.49 (GND), A1.50 (GND), A1.55 (GND), A1.56 (GND), A1.61 (GND), A1.62 (GND), A1.67 (GND), A1.68 (GND), A1.73 (GND), A1.74 (GND), A1.79 (GND), A1.80 (GND), A1.85 (GND), A1.86 (GND), A1.102 (GND), A1.107 (GND), A1.113 (GND), A1.119 (GND), A1.125 (GND), A1.129 (GND), A1.132 (GND), A1.135 (GND), A1.138 (GND), A1.141 (GND), A1.144 (GND), A1.146 (GND), A1.147 (GND), A1.152 (GND), A1.153 (GND), A1.158 (GND), A1.159 (GND), A1.164 (GND), A1.165 (GND), A1.170 (GND), A1.171 (GND), A1.176 (GND), A1.177 (GND), A1.200 (GND), A1.201 (GND), A1.231 (GND), A1.241 (GND), A1.242 (GND), A1.243 (GND), A1.244 (GND), A1.245 (GND), A1.246 (GND), A1.247 (GND), A1.248 (GND), A1.249 (GND), A1.250 (GND), C82.1, C83.1, J11.1, J12.1, U28.3 (GND)
I2C2_SCL: A1.232 (I2C2_SCL)
I2C2_SDA: A1.234 (I2C2_SDA)
I2S1_FS: A1.224 (I2S1_FS)
I2S1_SCLK: A1.226 (I2S1_SCLK)
I2S1_SDIN: A1.222 (I2S1_DIN)
I2S1_SDOUT: A1.220 (I2S1_DOUT)
M2E_SUSCLK_32KHZ: R86.1, U28.4 (Y)
unnamed: A1.10 (CSI0_CLK_N), TP7.1
unnamed: A1.12 (CSI0_CLK_P), TP8.1
unnamed: A1.27 (CSI3_CLK_N), TP5.1
unnamed: A1.29 (CSI3_CLK_P), TP6.1
unnamed: A1.178 (MOD_SLEEP*), TP12.1
unnamed: A1.217 (GND(MODULE_ID)), R105.1, TP4.1
unnamed: A1.235 (PMIC_BBAT), TP11.1
PCIE0_CLK_N: A1.160 (PCIE0_CLK_N)
PCIE0_CLK_P: A1.162 (PCIE0_CLK_P)
PCIE0_RX0_N: A1.131 (PCIE0_RX0_N)
PCIE0_RX0_P: A1.133 (PCIE0_RX0_P)
PCIE0_RX1_N: A1.137 (PCIE0_RX1_N)
PCIE0_RX1_P: A1.139 (PCIE0_RX1_P)
PCIE0_RX2_N: A1.149 (PCIE0_RX2_N)
PCIE0_RX2_P: A1.151 (PCIE0_RX2_P)
PCIE0_RX3_N: A1.155 (PCIE0_RX3_N)
PCIE0_RX3_P: A1.157 (PCIE0_RX3_P)
PCIE0_TX0_N: A1.134 (PCIE0_TX0_N)
PCIE0_TX0_P: A1.136 (PCIE0_TX0_P)
PCIE0_TX1_N: A1.140 (PCIE0_TX1_N)
PCIE0_TX1_P: A1.142 (PCIE0_TX1_P)
PCIE0_TX2_N: A1.148 (PCIE0_TX2_N)
PCIE0_TX2_P: A1.150 (PCIE0_TX2_P)
PCIE0_TX3_N: A1.154 (PCIE0_TX3_N)
PCIE0_TX3_P: A1.156 (PCIE0_TX3_P)
PCIE1_CLK_N: A1.173 (PCIE1_CLK_N)
PCIE1_CLK_P: A1.175 (PCIE1_CLK_P)
PCIE1_RX0_N: A1.167 (PCIE1_RX0_N)
PCIE1_RX0_P: A1.169 (PCIE1_RX0_P)
PCIE1_TX0_N: A1.172 (PCIE1_TX0_N)
PCIE1_TX0_P: A1.174 (PCIE1_TX0_P)
POWER_EN: A1.237 (POWER_EN)
PWR_LED_CTRL: A1.127 (GPIO04), TP10.1
RECOVERY_I2C_SCL: A1.185 (I2C0_SCL)
RECOVERY_I2C_SDA: A1.187 (I2C0_SDA)
UART0_CTS: A1.105 (UART0_CTS*)
UART0_RTS: A1.103 (UART0_RTS*)
UART0_RXD: A1.101 (UART0_RXD)
UART0_TXD: A1.99 (UART0_TXD)
UART2_RXD: A1.238 (UART2_RXD)
UART2_TXD: A1.236 (UART2_TXD)
USB0_D_N: A1.109 (USB0_D_N)
USB0_D_P: A1.111 (USB0_D_P)
USB1_D_N: A1.115 (USB1_D_N)
USB1_D_P: A1.117 (USB1_D_P)
USB2_D_N: A1.121 (USB2_D_N)
USB2_D_P: A1.123 (USB2_D_P)
USBSS0_RX_N: A1.161 (USBSS0_RX_N)
USBSS0_RX_P: A1.163 (USBSS0_RX_P)
USBSS0_TX_N: A1.166 (USBSS0_TX_N)
USBSS0_TX_P: A1.168 (USBSS0_TX_P)
USBSS1_RX_N: A1.39 (USBSS1_RX_N)
USBSS1_RX_P: A1.41 (USBSS1_RX_P)
USBSS1_TX_N: A1.45 (USBSS1_TX_N)
USBSS1_TX_P: A1.47 (USBSS1_TX_P)
W_DISABLE1_CTRL: A1.128 (GPIO05)
~FORCE_RECOVERY: A1.214 (FORCE_RECOVERY*), R95.1
~M2_ALERT: A1.212 (GPIO10)
~PCIE0_CLKREQ: A1.180 (PCIE0_CLKREQ*)
~PCIE0_RST: A1.181 (PCIE0_RST*)
~PCIE1_CLKREQ: A1.182 (PCIE1_CLKREQ*)
~PCIE1_RST: A1.183 (PCIE1_RST*)
~PCIE_WAKE: A1.179 (PCIE_WAKE*)
~PWR_BTN: A1.240 (SLEEP/WAKE*)
~SHUTDOWN_REQ: A1.233 (SHUTDOWN_REQ*)
~SYS_RST: A1.239 (SYS_RESET*)
~USB0_VBUS_DET: A1.87 (USB_VBUS_EN0/GPIO00)
