0y8w1x/daemon_carrier_board/switched_3V3_5V.kicad_sch

## KiCad design switched_3V3_5V.kicad_sch (2024-04-20)

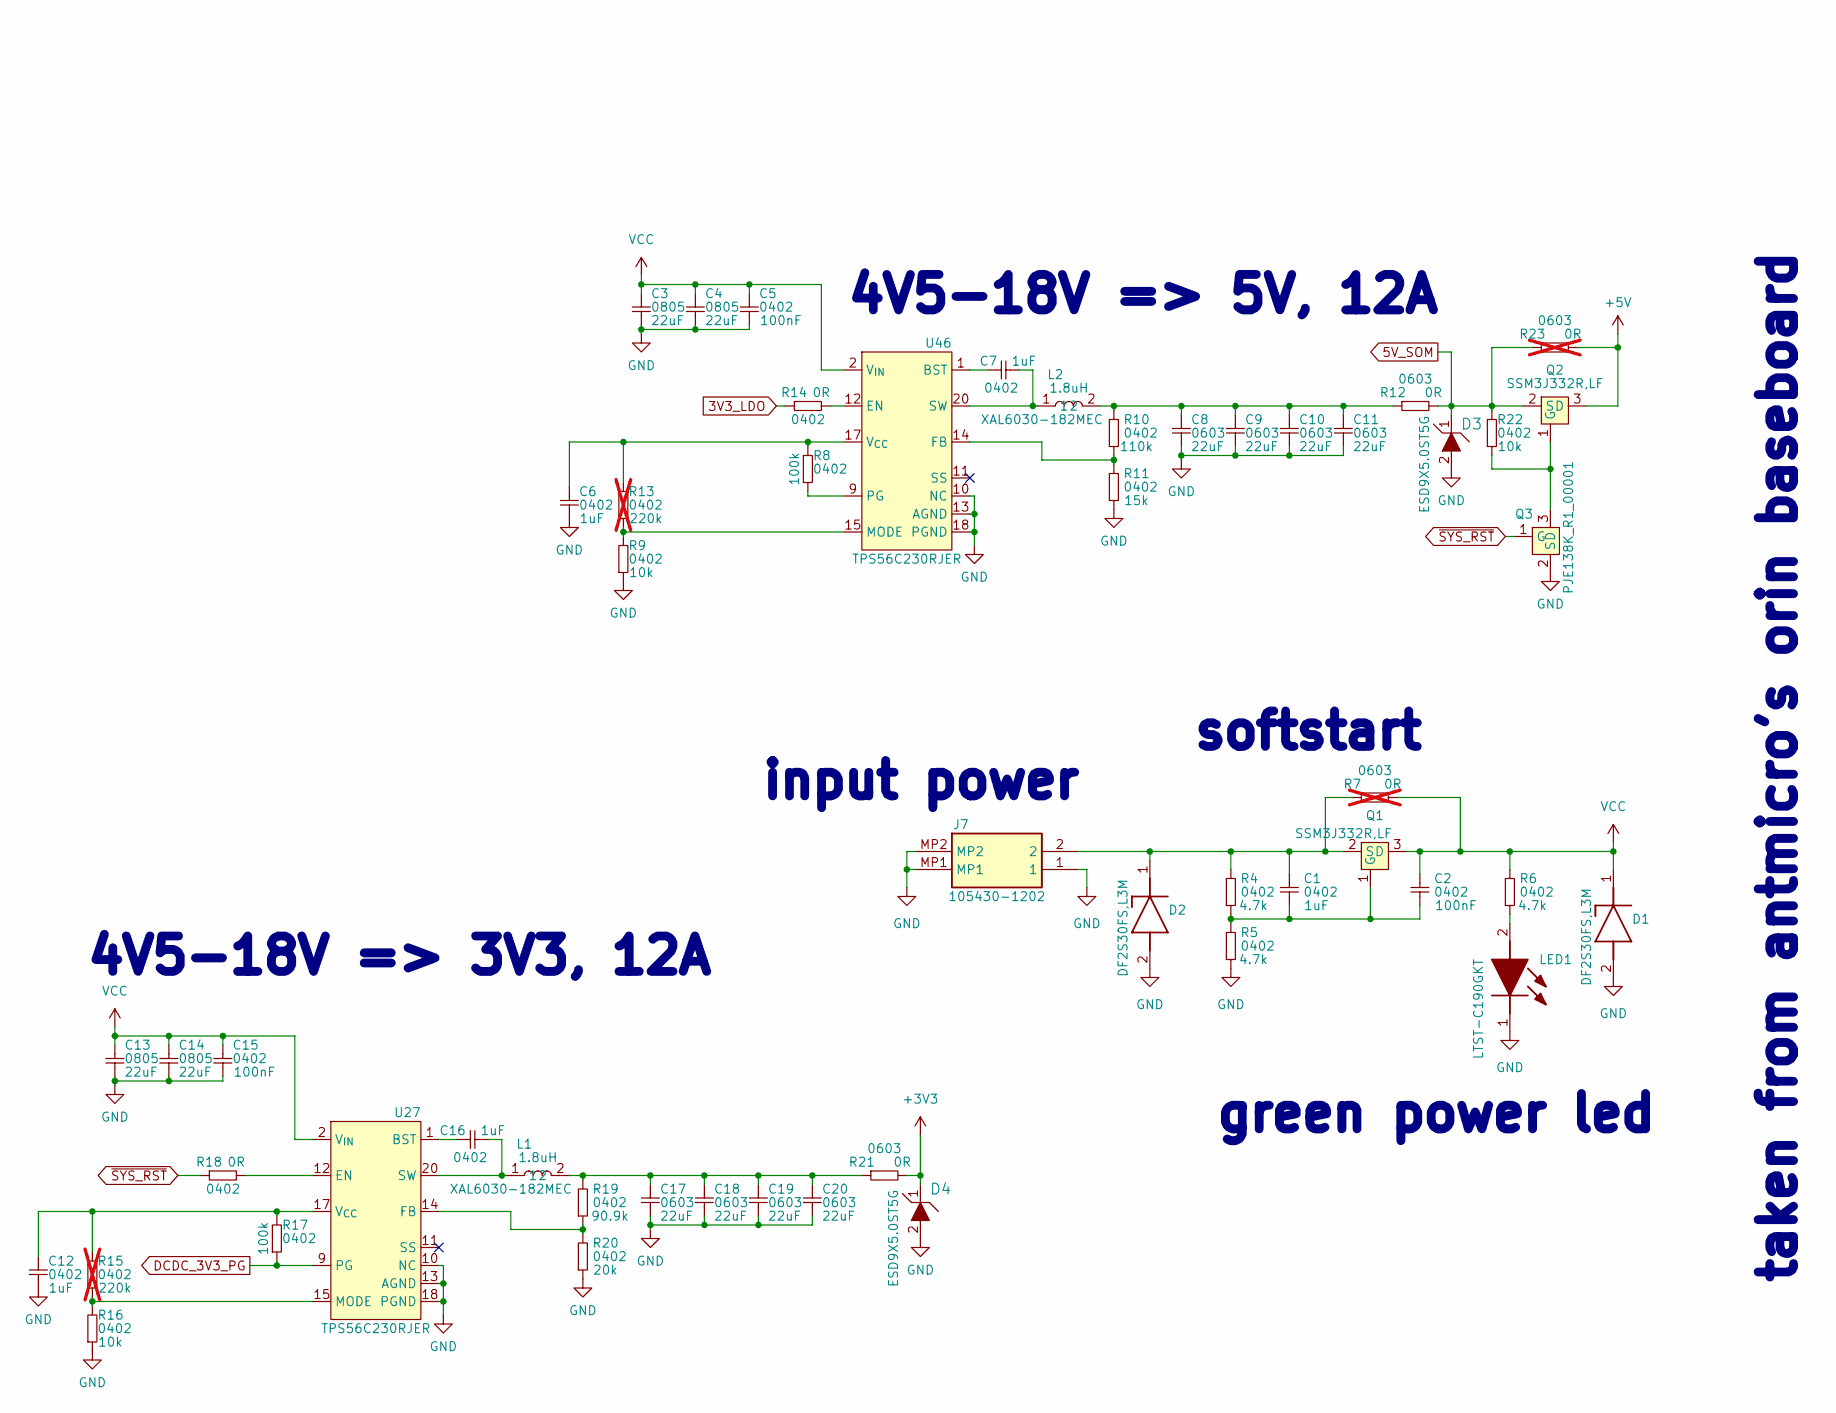
[picture p17: schematic switched_3V3_5V.kicad_sch]

Parts:
C1, C6, C7, C12, C16: 1uF; 0402_cap
C2, C5, C15: 100nF; 0402_cap
C3, C4, C13, C14: 22uF; 0805
C8, C9, C10, C11, C17, C18, C19, C20: 22uF; 0603_cap
D1, D2: SODFL1006X45N; Mouser Part Number 757-DF2S30FSL3M
D3, D4: SOD-923; MPN ESD9X5.0ST5G
J7: 1054301202; Mouser Part Number 538-105430-1202
L1, L2: 1.8uH; XAL6030
LED1: LEDC1608X90N; Mouser Part Number 859-LTST-C190GKT
Q1, Q2: SSM3J332R
Q3: PJE138K
R4, R5, R6: 4.7k; 0402_res
R7, R23: 0R; 0603_res; not fitted
R8, R17: 100k; 0402_res
R9, R16, R22: 10k; 0402_res
R10: 110k; 0402_res
R11: 15k; 0402_res
R12, R21: 0R; 0603_res
R13, R15: 220k; 0402_res; not fitted
R14, R18: 0R; 0402_res
R19: 90.9k; 0402_res
R20: 20k; 0402_res
U27, U46: QFN-20_EP_3x3_Pitch0.45mm; MPN TPS56C230RJER

Connections:
3V3_LDO: R14.1
5V_SOM: D3.1, Q2.2 (S), R12.2, R22.2, R23.1
+3V3: D4.1, R21.2
+5V: Q2.3 (D), R23.2
DCDC_3V3_PG: R17.1, U27.9 (PG)
GND: C3.1, C4.1, C5.1, C6.1, C8.1, C9.1, C10.1, C11.1, C12.1, C13.1, C14.1, C15.1, C17.1, C18.1, C19.1, C20.1, D1.2 (A), D2.2 (A), D3.2, D4.2, J7.1, J7.MP1, J7.MP2, LED1.1 (K), Q3.2 (S), R5.1, R9.1, R11.1, R16.1, R20.1, U27.7 (PGND), U27.8 (PGND), U27.10 (NC), U27.13 (AGND), U27.16 (NC), U27.18 (PGND), U27.21 (PGND), U46.7 (PGND), U46.8 (PGND), U46.10 (NC), U46.13 (AGND), U46.16 (NC), U46.18 (PGND), U46.21 (PGND)
unnamed: C1.1, C2.1, Q1.1 (G), R4.1, R5.2
unnamed: C1.2, D2.1 (K), J7.2, Q1.2 (S), R4.2, R7.1
unnamed: C6.2, R8.2, R13.2, U46.17 (V_{CC})
unnamed: C7.1, L2.1, U46.6 (SW), U46.19 (SW), U46.20 (SW)
unnamed: C7.2, U46.1 (BST)
unnamed: C8.2, C9.2, C10.2, C11.2, L2.2, R10.2, R12.1
unnamed: C12.2, R15.2, R17.2, U27.17 (V_{CC})
unnamed: C16.1, L1.1, U27.6 (SW), U27.19 (SW), U27.20 (SW)
unnamed: C16.2, U27.1 (BST)
unnamed: C17.2, C18.2, C19.2, C20.2, L1.2, R19.2, R21.1
unnamed: LED1.2 (A), R6.1
unnamed: Q2.1 (G), Q3.3 (D), R22.1
unnamed: R8.1, U46.9 (PG)
unnamed: R10.1, R11.2, U46.14 (FB)
unnamed: R9.2, R13.1, U46.15 (MODE)
unnamed: R14.2, U46.12 (EN)
unnamed: R15.1, R16.2, U27.15 (MODE)
unnamed: R18.2, U27.12 (EN)
unnamed: R19.1, R20.2, U27.14 (FB)
VCC: C2.2, C3.2, C4.2, C5.2, C13.2, C14.2, C15.2, D1.1 (K), Q1.3 (D), R6.2, R7.2, U27.2 (V_{IN}), U27.3 (V_{IN}), U27.4 (V_{IN}), U27.5 (V_{IN}), U46.2 (V_{IN}), U46.3 (V_{IN}), U46.4 (V_{IN}), U46.5 (V_{IN})
~SYS_RST: Q3.1 (G), R18.1

Notes on the sheet:
softstart
green power led
4V5-18V => 3V3, 12A
input power
taken from antmicro's orin baseboard
4V5-18V => 5V, 12A
