0y8w1x/daemon_carrier_board/usb_3.2.kicad_sch

## KiCad design usb_3.2.kicad_sch (2024-04-20)

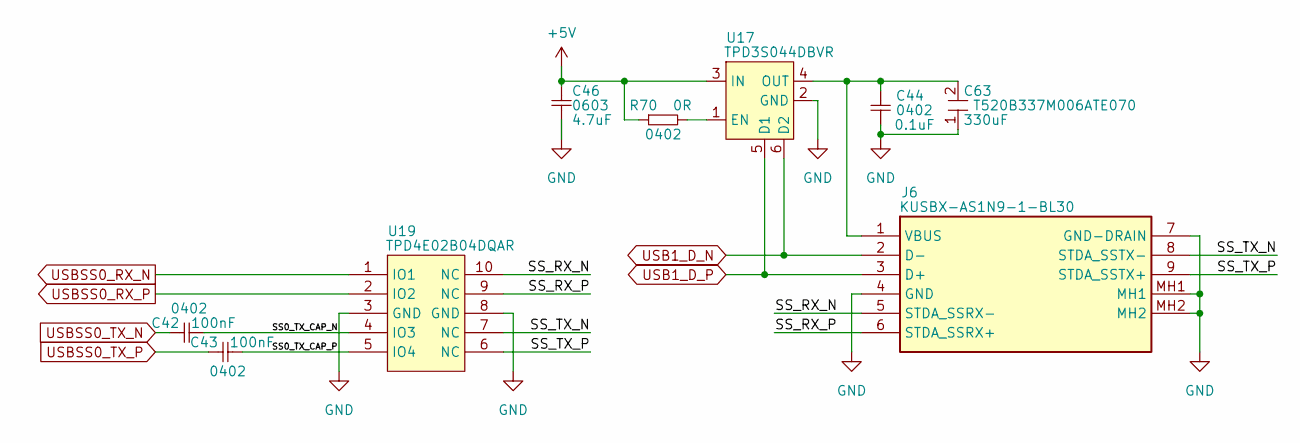
[picture p18: schematic usb_3.2.kicad_sch]

Parts:
C42, C43: 100nF; 0402_cap
C44: 0.1uF; 0402_cap
C46: 4.7uF; 0603_cap
C63: 330uF; T520B337M006ATE070
J6: KUSBXAS1N91BL30; Mouser Part Number 806-KUSBX-AS1N91BL30
R70: 0R; 0402_res
U17: TPD3S044
U19: TPD4E02B04DQAR

Connections:
+5V: C46.2, R70.1, U17.3 (IN)
GND: C44.1, C46.1, C63.1, J6.4 (GND), J6.7 (GND-DRAIN), J6.MH1, J6.MH2, U17.2 (GND), U19.3 (GND), U19.8 (GND)
unnamed: C44.2, C63.2, J6.1 (VBUS), U17.4 (OUT)
unnamed: R70.2, U17.1 (EN)
SS0_TX_CAP_N: C42.1, U19.4 (IO3)
SS0_TX_CAP_P: C43.1, U19.5 (IO4)
SS_RX_N: J6.5 (STDA_SSRX-), U19.10 (NC)
SS_RX_P: J6.6 (STDA_SSRX+), U19.9 (NC)
SS_TX_N: J6.8 (STDA_SSTX-), U19.7 (NC)
SS_TX_P: J6.9 (STDA_SSTX+), U19.6 (NC)
USB1_D_N: J6.2 (D-), U17.6 (D2)
USB1_D_P: J6.3 (D+), U17.5 (D1)
USBSS0_RX_N: U19.1 (IO1)
USBSS0_RX_P: U19.2 (IO2)
USBSS0_TX_N: C42.2
USBSS0_TX_P: C43.2
