0y8w1x/daemon_carrier_board/usb_c_recovery.kicad_sch

## KiCad design usb_c_recovery.kicad_sch (2024-04-20)

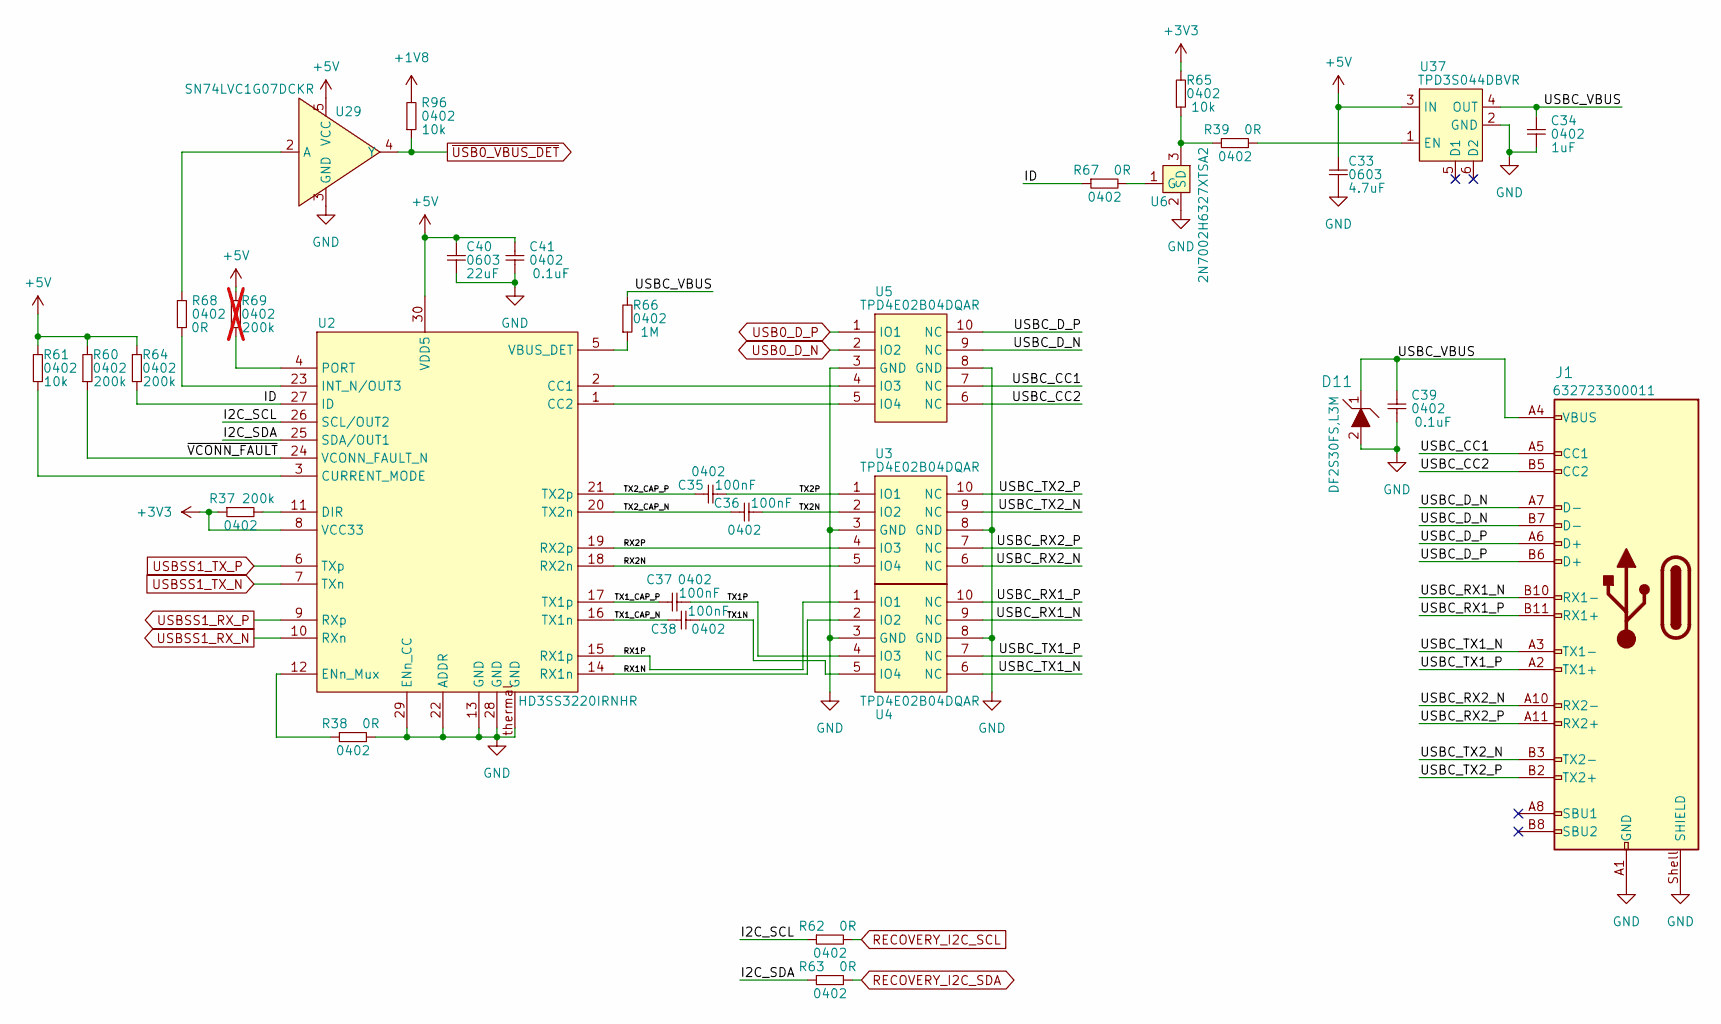
[picture p19: schematic usb_c_recovery.kicad_sch]

Parts:
C33: 4.7uF; 0603_cap
C34: 1uF; 0402_cap
C35, C36, C37, C38: 100nF; 0402_cap
C39, C41: 0.1uF; 0402_cap
C40: 22uF; 0603_cap
D11: SOD-923; MPN DF2S30FS
J1: WE_632723300011; MPN 632723300011
R37, R60, R64: 200k; 0402_res
R38, R39, R62, R63, R67, R68: 0R; 0402_res
R61, R65, R96: 10k; 0402_res
R66: 1M; 0402_res
R69: 200k; 0402_res; not fitted
U2: HD3SS3220IRNHR
U3, U4, U5: TPD4E02B04DQAR
U6: 2N7002
U29: SN74LVC1G07
U37: TPD3S044

Connections:
+1V8: R96.2
+3V3: R37.1, R65.2, U2.8 (VCC33)
+5V: C33.2, C40.2, C41.2, R60.2, R61.2, R64.2, R69.2, U2.30 (VDD5), U29.5 (VCC), U37.3 (IN)
GND: C33.1, C34.1, C39.1, C40.1, C41.1, D11.2, J1.A1 (GND), J1.A12 (GND), J1.B1 (GND), J1.B12 (GND), J1.Shell (SHIELD), R38.2, U2.13 (GND), U2.22 (ADDR), U2.28 (GND), U2.29 (ENn_CC), U2.thermal (GND), U3.3 (GND), U3.8 (GND), U4.3 (GND), U4.8 (GND), U5.3 (GND), U5.8 (GND), U6.2 (S), U29.3 (GND), U37.2 (GND)
I2C_SCL: R62.1, U2.26 (SCL/OUT2)
I2C_SDA: R63.1, U2.25 (SDA/OUT1)
ID: R64.1, R67.1, U2.27 (ID)
unnamed: R37.2, U2.11 (DIR)
unnamed: R38.1, U2.12 (ENn_Mux)
unnamed: R39.1, R65.1, U6.3 (D)
unnamed: R39.2, U37.1 (EN)
unnamed: R61.1, U2.3 (CURRENT_MODE)
unnamed: R66.1, U2.5 (VBUS_DET)
unnamed: R67.2, U6.1 (G)
unnamed: R68.1, U2.23 (INT_N/OUT3)
unnamed: R68.2, U29.2 (A)
unnamed: R69.1, U2.4 (PORT)
unnamed: U2.1 (CC2), U5.5 (IO4)
unnamed: U2.2 (CC1), U5.4 (IO3)
RECOVERY_I2C_SCL: R62.2
RECOVERY_I2C_SDA: R63.2
RX1N: U2.14 (RX1n), U4.2 (IO2)
RX1P: U2.15 (RX1p), U4.1 (IO1)
RX2N: U2.18 (RX2n), U3.5 (IO4)
RX2P: U2.19 (RX2p), U3.4 (IO3)
TX1N: C38.1, U4.5 (IO4)
TX1P: C37.1, U4.4 (IO3)
TX1_CAP_N: C38.2, U2.16 (TX1n)
TX1_CAP_P: C37.2, U2.17 (TX1p)
TX2N: C36.1, U3.2 (IO2)
TX2P: C35.1, U3.1 (IO1)
TX2_CAP_N: C36.2, U2.20 (TX2n)
TX2_CAP_P: C35.2, U2.21 (TX2p)
USB0_D_N: U5.2 (IO2)
USB0_D_P: U5.1 (IO1)
USBC_CC1: J1.A5 (CC1), U5.7 (NC)
USBC_CC2: J1.B5 (CC2), U5.6 (NC)
USBC_D_N: J1.A7 (D-), J1.B7 (D-), U5.9 (NC)
USBC_D_P: J1.A6 (D+), J1.B6 (D+), U5.10 (NC)
USBC_RX1_N: J1.B10 (RX1-), U4.9 (NC)
USBC_RX1_P: J1.B11 (RX1+), U4.10 (NC)
USBC_RX2_N: J1.A10 (RX2-), U3.6 (NC)
USBC_RX2_P: J1.A11 (RX2+), U3.7 (NC)
USBC_TX1_N: J1.A3 (TX1-), U4.6 (NC)
USBC_TX1_P: J1.A2 (TX1+), U4.7 (NC)
USBC_TX2_N: J1.B3 (TX2-), U3.9 (NC)
USBC_TX2_P: J1.B2 (TX2+), U3.10 (NC)
USBC_VBUS: C34.2, C39.2, D11.1, J1.A4 (VBUS), J1.A9 (VBUS), J1.B4 (VBUS), J1.B9 (VBUS), R66.2, U37.4 (OUT)
USBSS1_RX_N: U2.10 (RXn)
USBSS1_RX_P: U2.9 (RXp)
USBSS1_TX_N: U2.7 (TXn)
USBSS1_TX_P: U2.6 (TXp)
~USB0_VBUS_DET: R96.1, U29.4 (Y)
~VCONN_FAULT: R60.1, U2.24 (VCONN_FAULT_N)
