0y8w1x/daemon_carrier_board/(notices)

Notices in the files:
parts and their libraries:
License: MIT
